dhkar/digital-clock-7seg4dig/(commit log)

2021-04-10 add spec file (2nd task), fixed alarm feature bugs
    [src.ino]
2021-04-10 added LED for indicating modes (alarm/SW/Clock)
